test-account30/BeltClock/PCB/motherboard_MK2.pdf

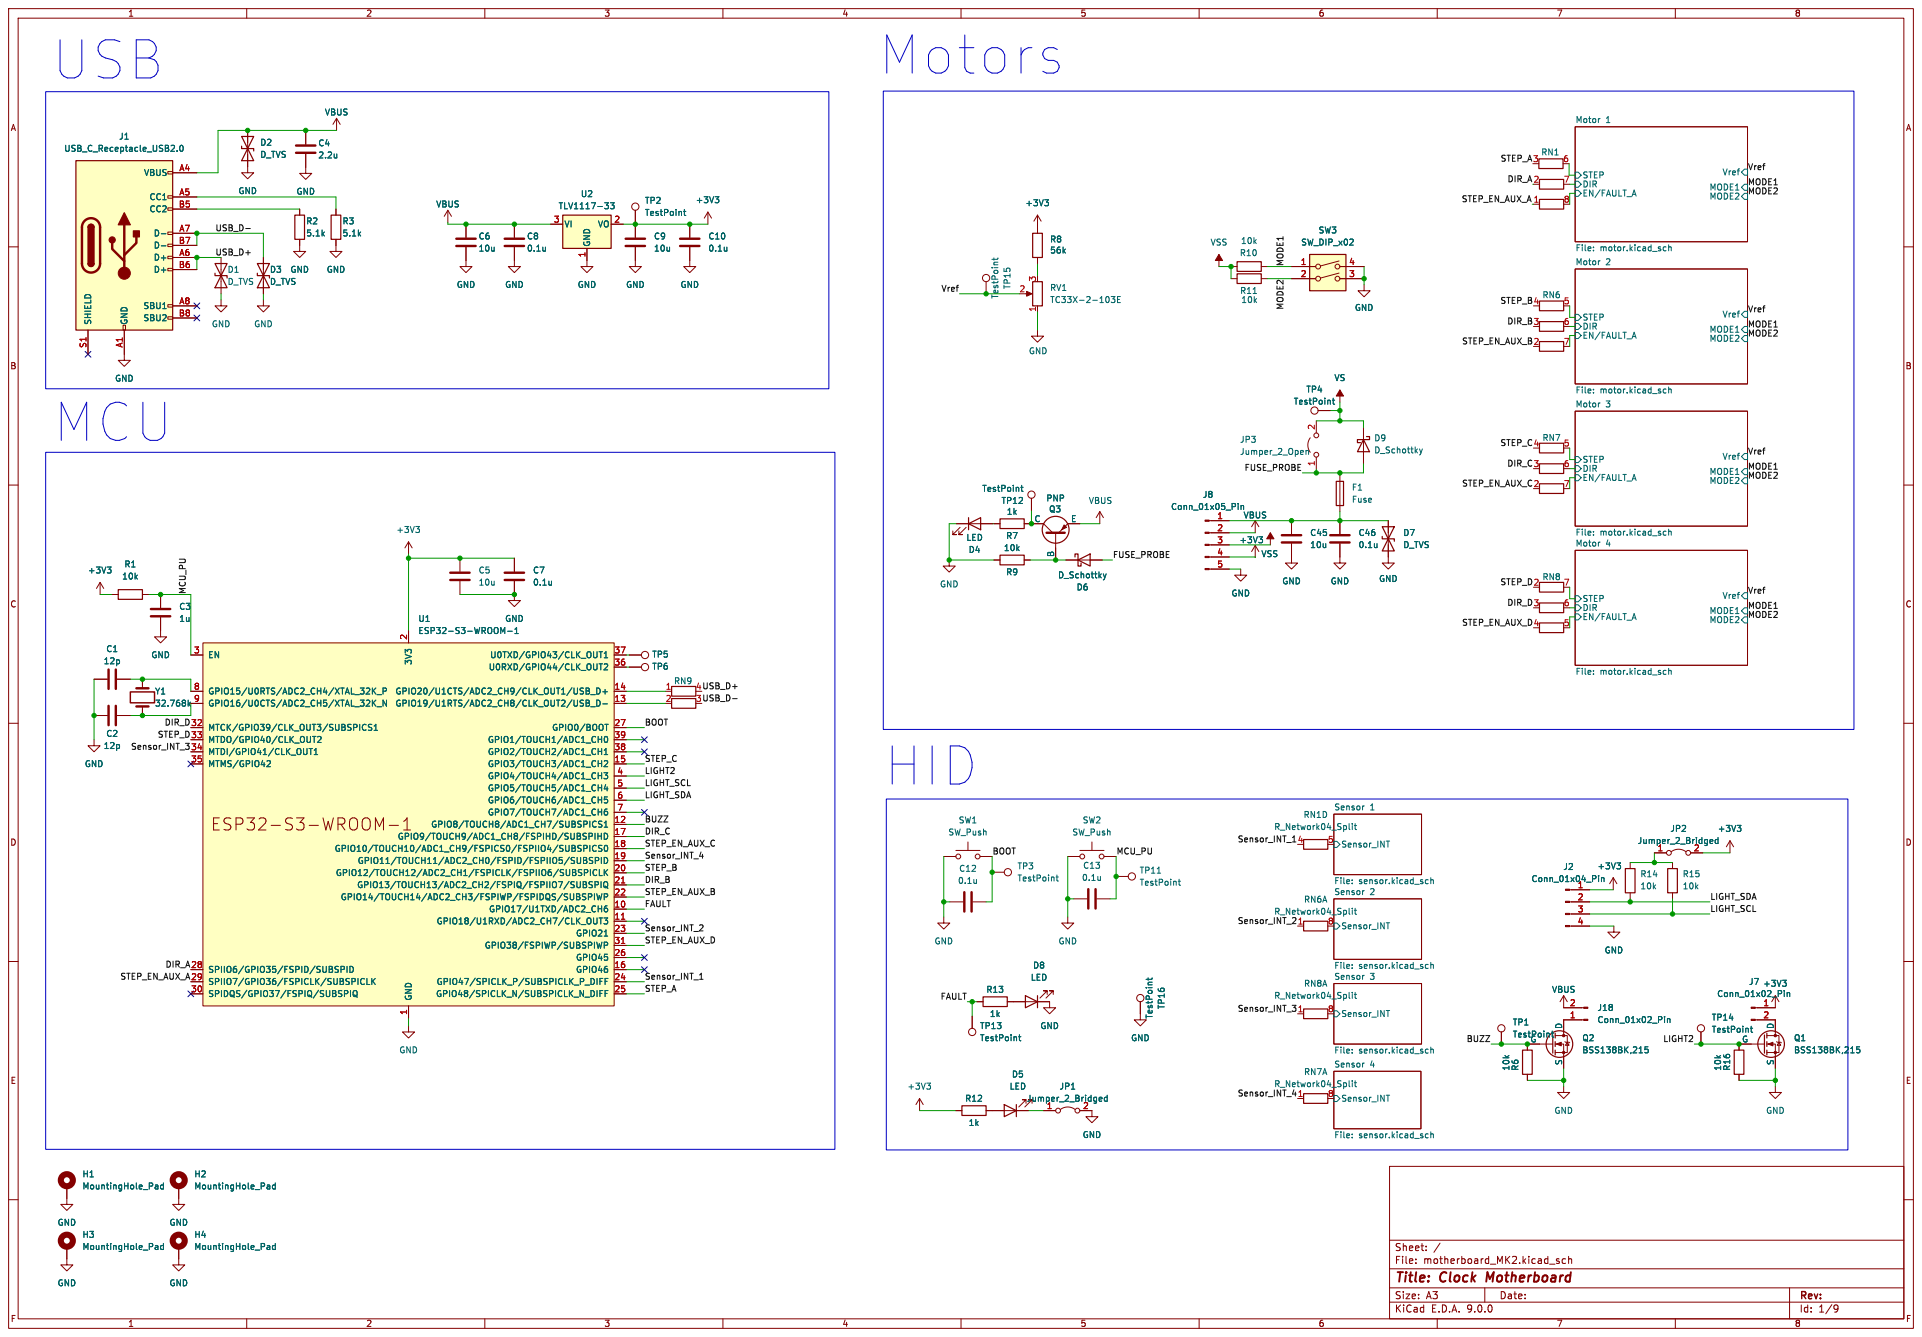
[picture p1: page 1]

1 U0TXD/GPIO43/CLK_OUT1 37 U0RXD/GPIO44/CLK_OUT2 36 GPIO20/U1CTS/ADC2_CH9/CLK_OUT1/USB_D+ 14 GPIO19/U1RTS/ADC2_CH8/CLK_OUT2/USB_D- 13 GPIO0/BOOT 27 GPIO1/TOUCH1/ADC1_CH0 39 GPIO2/TOUCH2/ADC1_CH1 38 GPIO3/TOUCH3/ADC1_CH2 15 GPIO4/TOUCH4/ADC1_CH3 4 GPIO5/TOUCH5/ADC1_CH4 5 GPIO6/TOUCH6/ADC1_CH5 6 GPIO7/TOUCH7/ADC1_CH6 7 GPIO8/TOUCH8/ADC1_CH7/SUBSPICS1 12 GPIO9/TOUCH9/ADC1_CH8/FSPIHD/SUBSPIHD 17 GPIO10/TOUCH10/ADC1_CH9/FSPICS0/FSPIIO4/SUBSPICS0 18 GPIO11/TOUCH11/ADC2_CH0/FSPID/FSPIIO5/SUBSPID 19 GPIO12/TOUCH12/ADC2_CH1/FSPICLK/FSPIIO6/SUBSPICLK 20 GPIO13/TOUCH13/ADC2_CH2/FSPIQ/FSPIIO7/SUBSPIQ 21 GPIO14/TOUCH14/ADC2_CH3/FSPIWP/FSPIDQS/SUBSPIWP 22 GPIO17/U1TXD/ADC2_CH6 10 GPIO18/U1RXD/ADC2_CH7/CLK_OUT3 11 GPIO21 23 GPIO38/FSPIWP/SUBSPIWP 31 GPIO45 26 GPIO46 16 GPIO47/SPICLK_P/SUBSPICLK_P_DIFF 24 GPIO48/SPICLK_N/SUBSPICLK_N_DIFF 25 U1ESP32-S3-WROOM-1 GND

1 U0TXD/GPIO43/CLK_OUT1 37 U0RXD/GPIO44/CLK_OUT2 36 GPIO20/U1CTS/ADC2_CH9/CLK_OUT1/USB_D+ 14 GPIO19/U1RTS/ADC2_CH8/CLK_OUT2/USB_D- 13 GPIO0/BOOT 27 GPIO1/TOUCH1/ADC1_CH0 39 GPIO2/TOUCH2/ADC1_CH1 38 GPIO3/TOUCH3/ADC1_CH2 15 GPIO4/TOUCH4/ADC1_CH3 4 GPIO5/TOUCH5/ADC1_CH4 5 GPIO6/TOUCH6/ADC1_CH5 6 GPIO7/TOUCH7/ADC1_CH6 7 GPIO8/TOUCH8/ADC1_CH7/SUBSPICS1 12 GPIO9/TOUCH9/ADC1_CH8/FSPIHD/SUBSPIHD 17 GPIO10/TOUCH10/ADC1_CH9/FSPICS0/FSPIIO4/SUBSPICS0 18 GPIO11/TOUCH11/ADC2_CH0/FSPID/FSPIIO5/SUBSPID 19 GPIO12/TOUCH12/ADC2_CH1/FSPICLK/FSPIIO6/SUBSPICLK 20 GPIO13/TOUCH13/ADC2_CH2/FSPIQ/FSPIIO7/SUBSPIQ 21 GPIO14/TOUCH14/ADC2_CH3/FSPIWP/FSPIDQS/SUBSPIWP 22 GPIO17/U1TXD/ADC2_CH6 10 GPIO18/U1RXD/ADC2_CH7/CLK_OUT3 11 GPIO21 23 GPIO38/FSPIWP/SUBSPIWP 31 GPIO45 26 GPIO46 16 GPIO47/SPICLK_P/SUBSPICLK_P_DIFF 24 GPIO48/SPICLK_N/SUBSPICLK_N_DIFF 25 H3 MountingHole_Pad H4 MountingHole_Pad GND

File: motherboard_MK2.kicad_sch Sheet: / Sensor_INT Sensor 4 File: sensor.kicad_sch Sensor_INT Sensor 3 File: sensor.kicad_sch

Id: 1/9 Title: Clock Motherboard

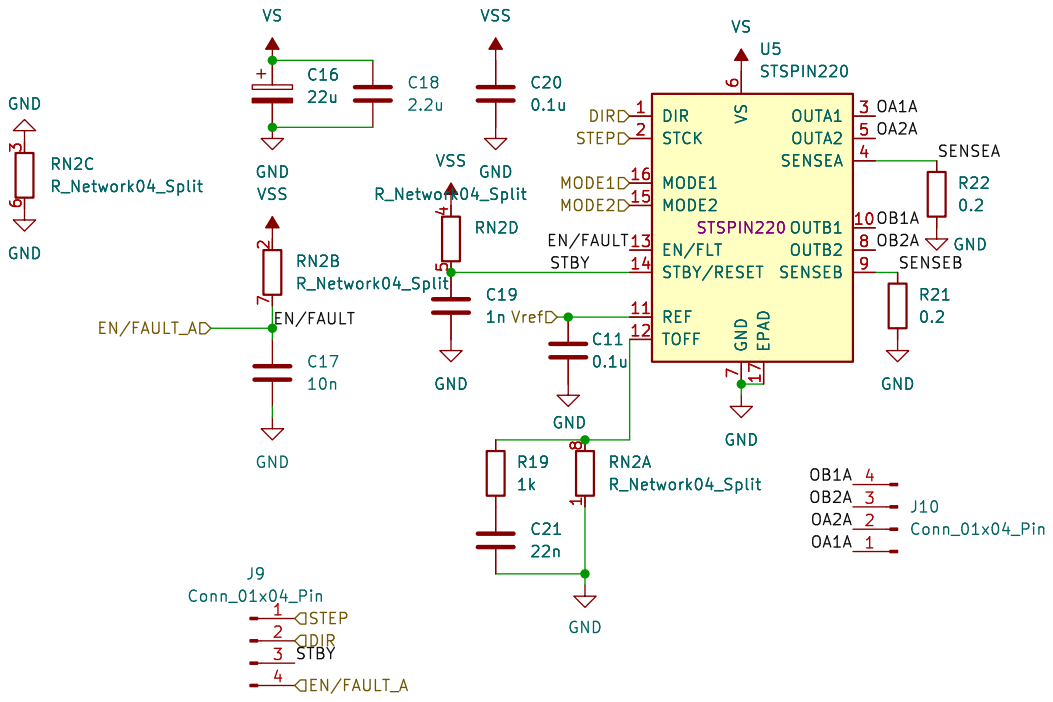
[picture p2: page 2]

7 EPAD 17 OUTA1 3 OUTA2 5 SENSEA 4 OUTB1 10 OUTB2 8 SENSEB 9 VS GND

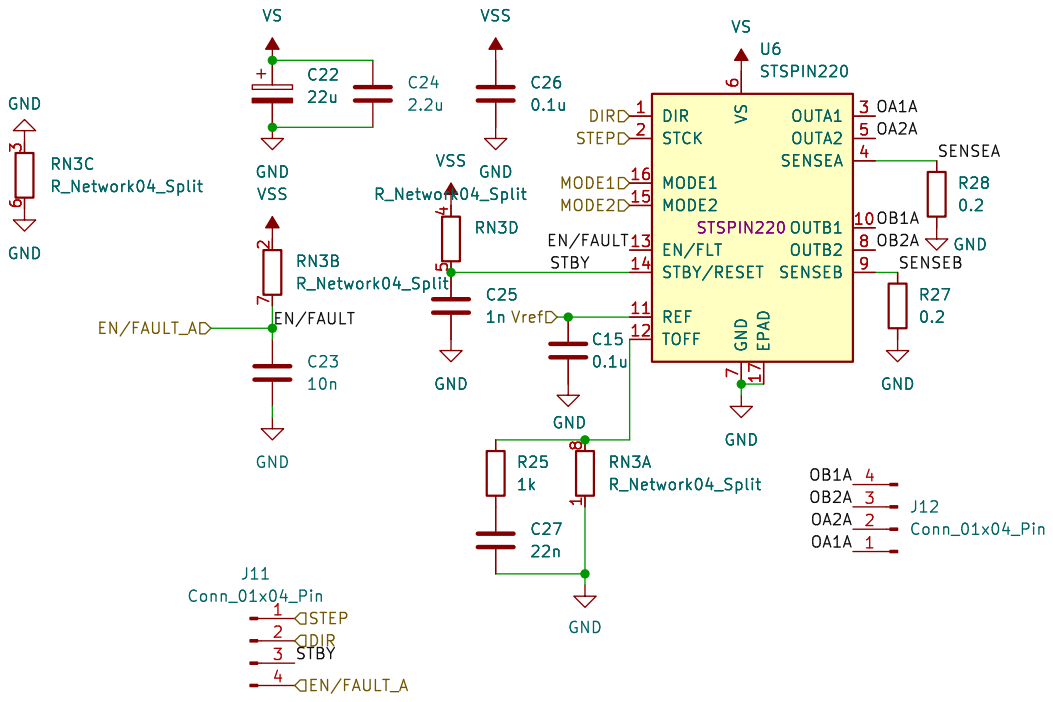
[picture p3: page 3]

7 EPAD 17 OUTA1 3 OUTA2 5 SENSEA 4 OUTB1 10 OUTB2 8 SENSEB 9 U6STSPIN220 STSPIN220 GND

7 EPAD 17 OUTA1 3 OUTA2 5 SENSEA 4 OUTB1 10 OUTB2 8 SENSEB 9 GND

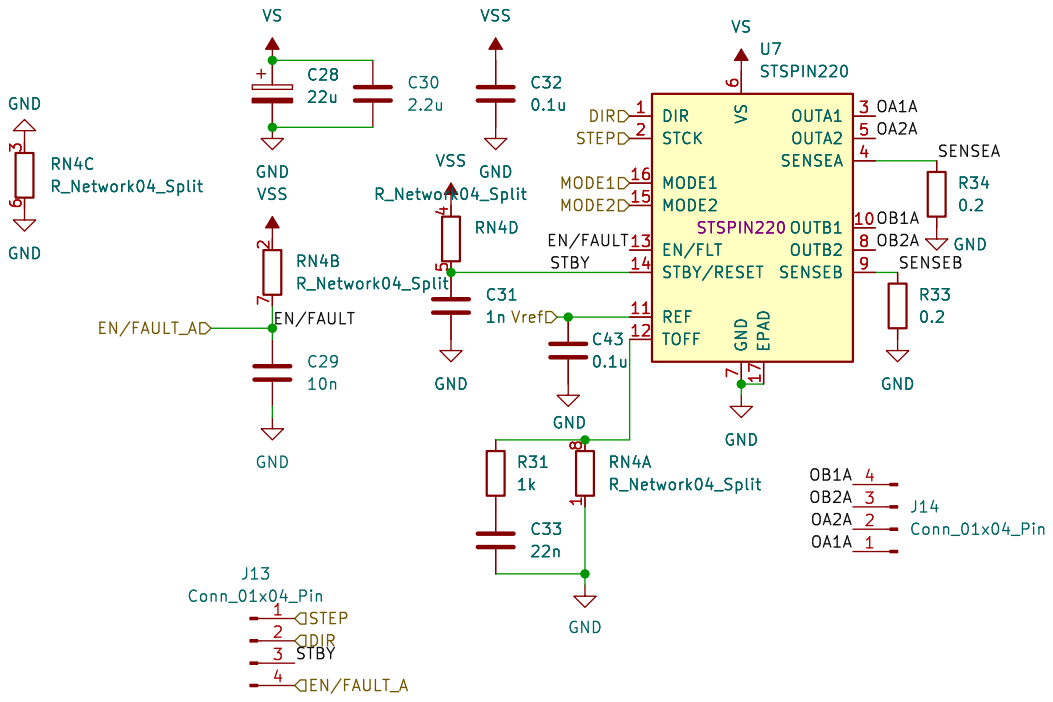
[picture p4: page 4]
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

7 EPAD 17 OUTA1 3 OUTA2 5 SENSEA 4 OUTB1 10 OUTB2 8 SENSEB 9 U7STSPIN220 STSPIN220 GND

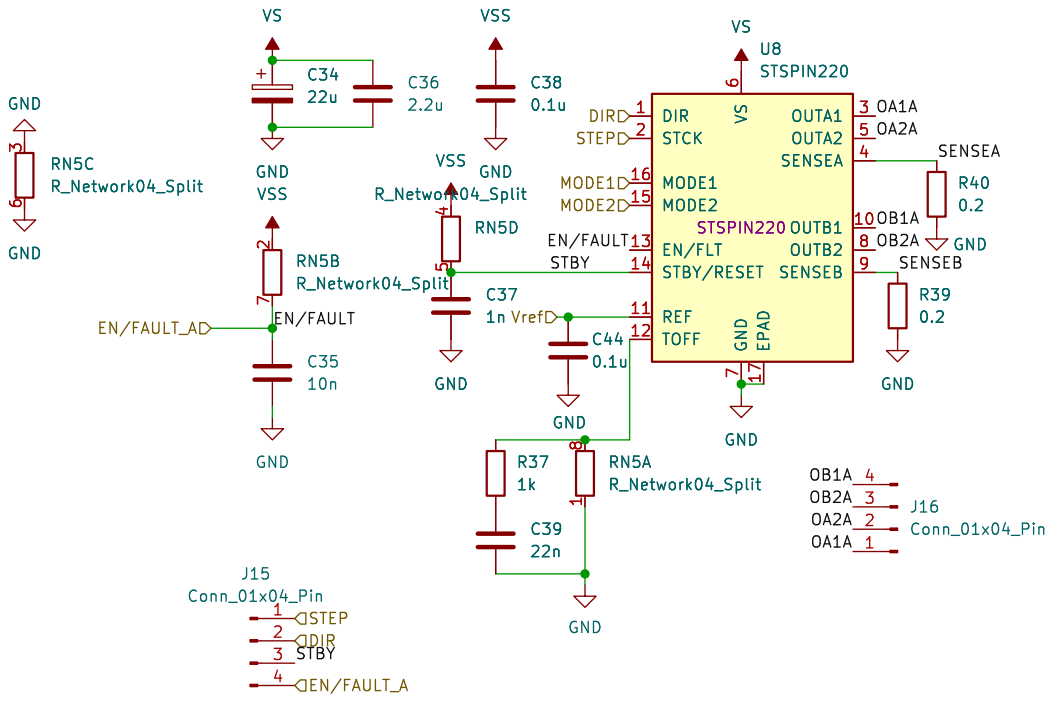
[picture p5: page 5]

7 EPAD 17 OUTA1 3 OUTA2 5 SENSEA 4 OUTB1 10 OUTB2 8 SENSEB 9 U8STSPIN220 STSPIN220 GND

7 EPAD 17 OUTA1 3 OUTA2 5 SENSEA 4 OUTB1 10 OUTB2 8 SENSEB 9 GND

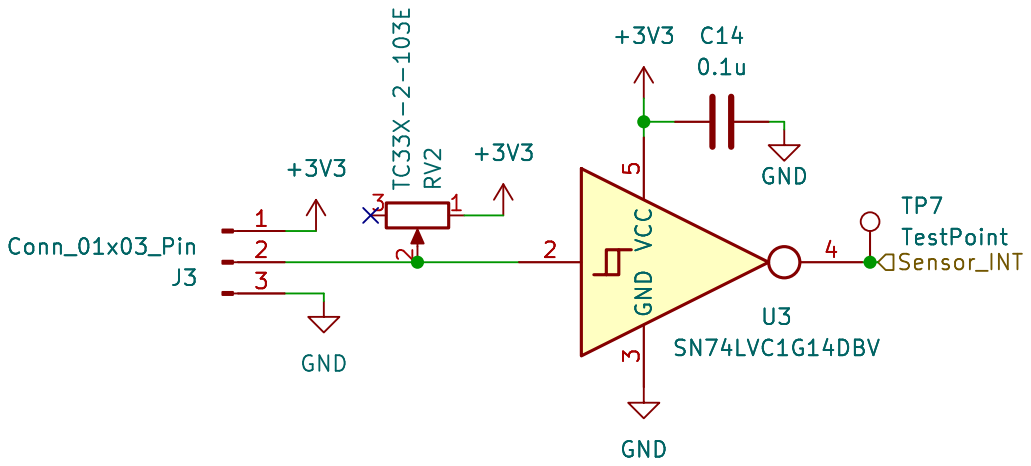
[picture p6: page 6]

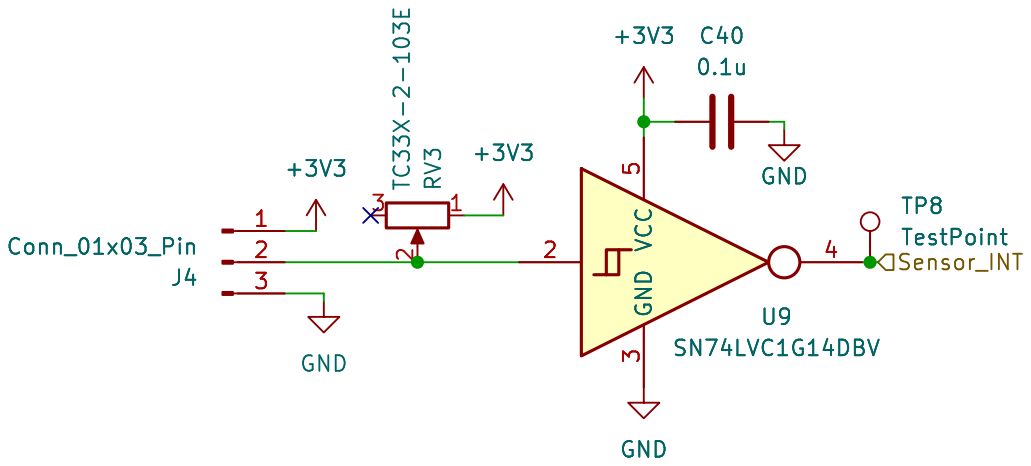
[picture p7: page 7]

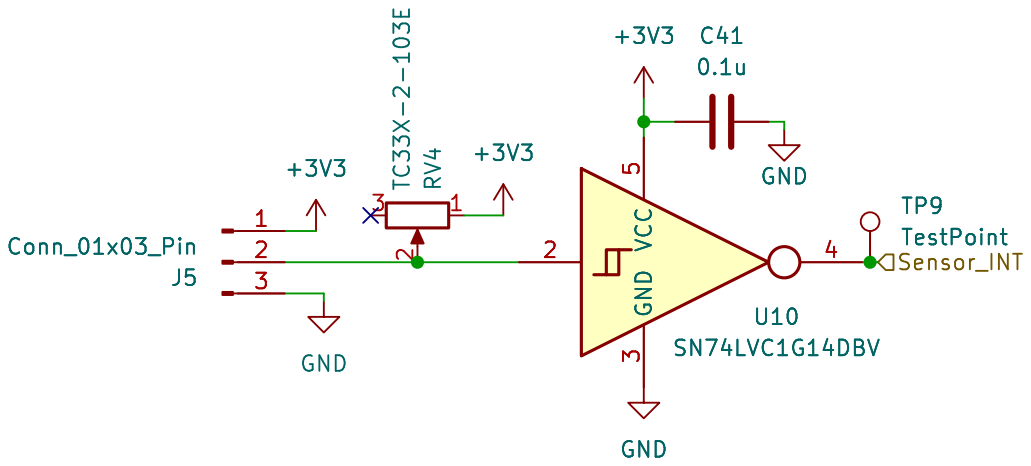
[picture p8: page 8]

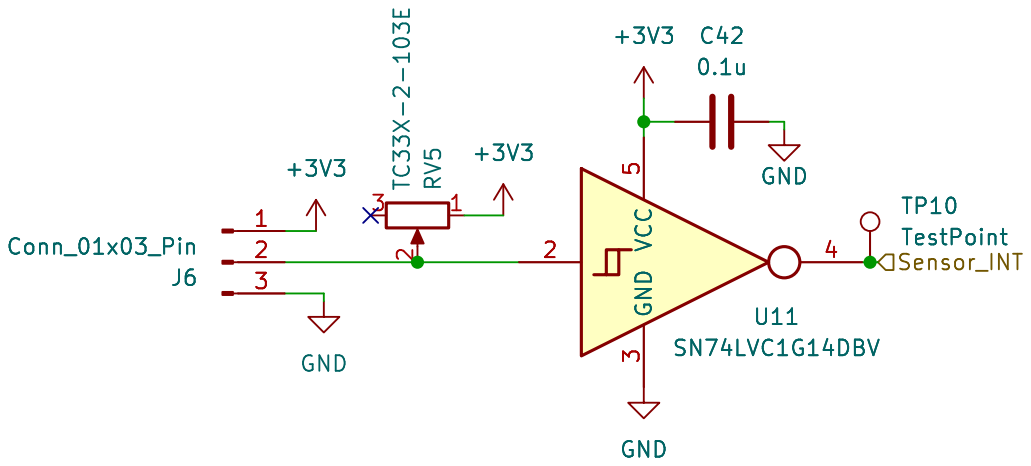
[picture p9: page 9]
