test-account30/BeltClock/PCB/motherboard_MK2.kicad_pcb

## KiCad design PCB/motherboard_MK2.kicad_pcb (2025-03-05)

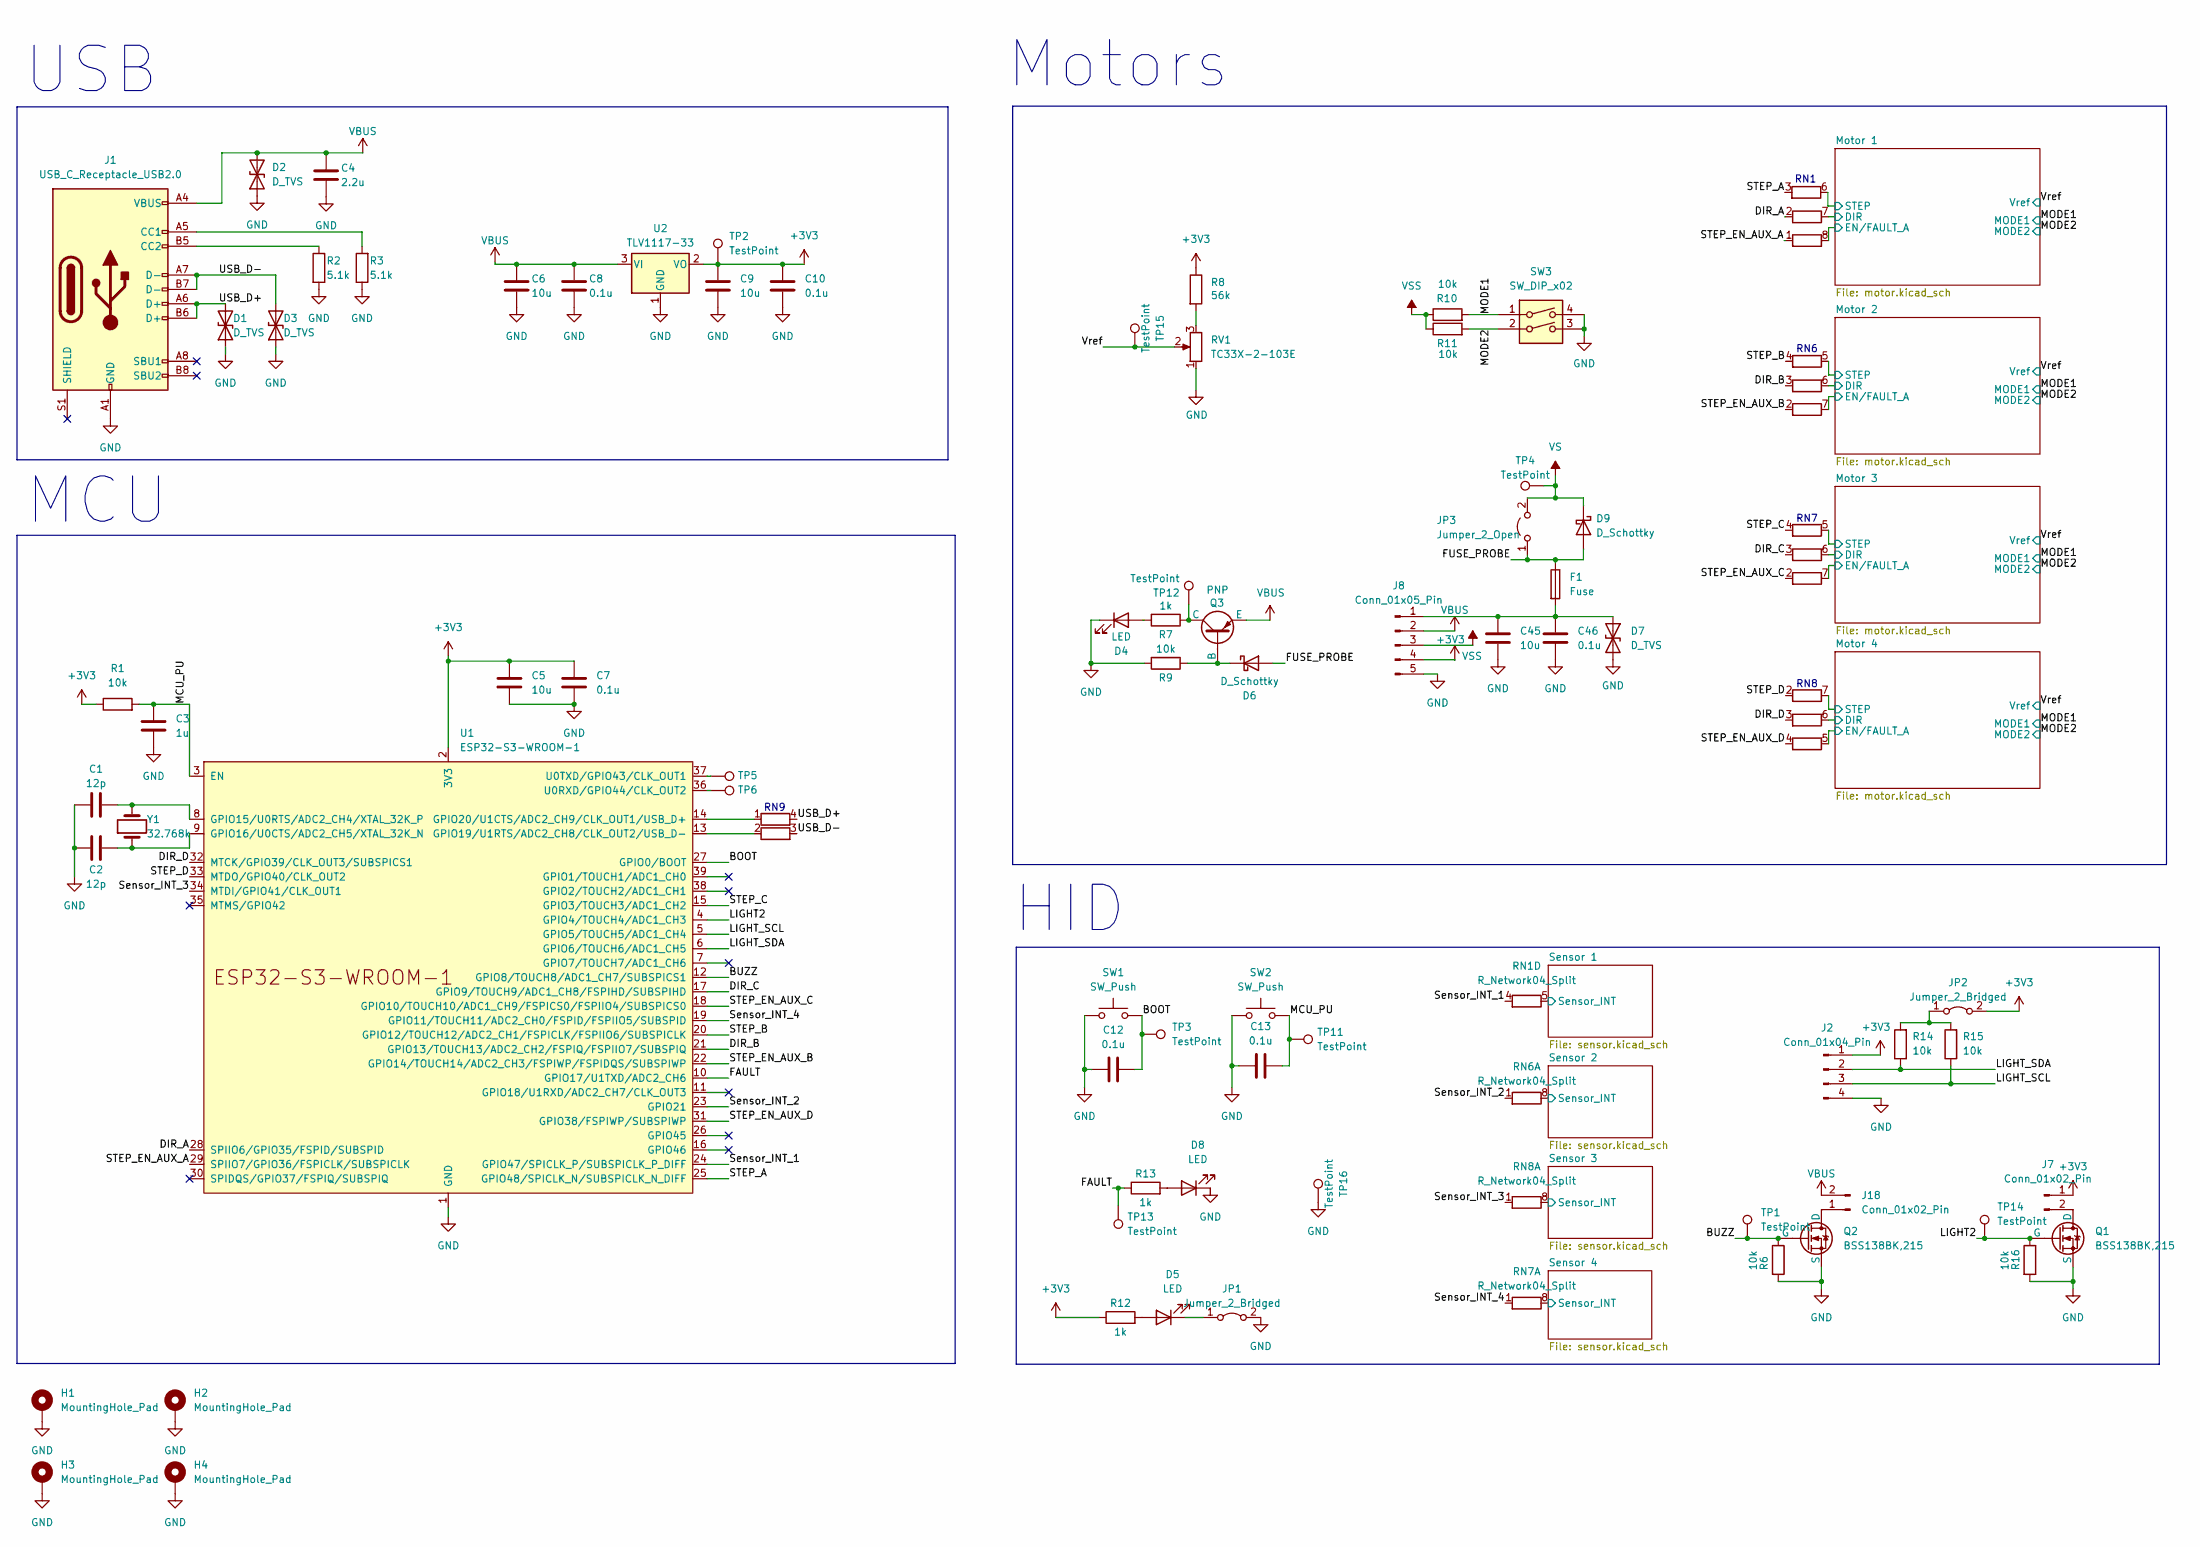
[picture p10: schematic motherboard_MK2.kicad_sch, Clock Motherboard]

Parts:
C1, C2: 12p; C_0603_1608Metric; Part Number VJ0805A120FXJCW1BC
C3: 1u; C_0603_1608Metric; Part Number CL10A105KO8NNNC
C4: 2.2u; C_0603_1608Metric; Part Number CL10A225KO8NNNC
C5, C6, C9, C45: 10u; C_1206_3216Metric; Part Number C1206C106K4PACTU
C7, C8, C10, C12, C13, C46: 0.1u; C_0603_1608Metric; Part Number CL10B104KO8NNNC
D1, D3: D_TVS; D_SOD-882; Part Number SP3021-01ETG
D2, D7: D_TVS; ZDO_SOD723_LTF-L; Part Number SP1003-01DTG
D4, D5, D8: LED; LED_0805_2012Metric; Part Number MCL-S270YC
D6: D_Schottky; D_SOD-523; Part Number RB540SM-40FHT2R
D9: D_Schottky; Nexperia_CFP3_SOD-123W; Part Number PMEG4030EXEX
F1: Fuse; Fuse_1206_3216Metric; Part Number F1206FA3000V032TM
H1, H2, H3, H4: MountingHole_Pad; MountingHole_3.2mm_M3; Part Number N/A
J1: USB_C_Receptacle_USB2.0; USB4120-03-C_GCT; Part Number USB4120-03-C
J2: Conn_01x04_Pin; Molex_PicoBlade_53048-0410_1x04_P1.25mm_Horizontal; Part Number 53048-0410
J7: Conn_01x02_Pin; Molex_PicoBlade_53048-0210_1x02_P1.25mm_Horizontal; Part Number 53047-0210
J8: Conn_01x05_Pin; PinHeader_1x05_P2.54mm_Vertical; Part Number generic
J18: Conn_01x02_Pin; Molex_PicoBlade_53047-0210_1x02_P1.25mm_Vertical; Part Number 53047-0210
JP1, JP2: Jumper_2_Bridged; SolderJumper-2_P1.3mm_Bridged2Bar_Pad1.0x1.5mm; Part Number N/A
JP3: Jumper_2_Open; SolderJumper-2_P1.3mm_Open_Pad1.0x1.5mm; Part Number N/A
Q1, Q2: BSS138BK,215; SOT-23; Part Number BSS138BK,215
Q3: PNP; SOT-23; Part Number DSS5240T-7
R1, R6, R10, R11, R14, R15, R16: 10k; R_0603_1608Metric; Part Number MR06X1002FTLV
R2, R3: 5.1k; R_0603_1608Metric; Tolerance 1%; Part Number MCWR06X5101FTL
R7, R12, R13: 1k; R_0805_2012Metric; Tolerence 10%; Part Number MCWR08X1001FTL
R8: 56k; R_0603_1608Metric; Part Number MR06X563 JTLV
R9: 10k; R_0603_1608Metric; Tolerence 10%; Part Number MR06X1002FTLV
RN1, RN6, RN7, RN8: R_Network04_Split; R_Array_Convex_4x0402; Part Number MCPNF42JT-YR0R0
RN9: R_Pack02_Split; R_Array_Convex_2x0402; Part Number MCPNF22JT-YR0R0
RV1: TC33X-2-103E; Potentiometer_Bourns_TC33X_Vertical; Part Number TC33X-2-103E
SW1, SW2: SW_Push; SW_SPST_TL3305A; Part Number TL3305AF160QG.
SW3: SW_DIP_x02; DIP-4_W7.62mm; Part Number MCNDI-02S
TP1, TP3, TP11, TP12, TP13, TP14: TestPoint; TestPoint_Pad_D1.0mm; Part Number N/A
TP2, TP4, TP5, TP6, TP16: TestPoint; TestPoint_Pad_1.0x1.0mm; Part Number N/A
TP15: TestPoint; TestPoint_Pad_2.0x2.0mm; Part Number N/A
U1: ESP32-S3-WROOM-1; Part Number DFR0896
U2: TLV1117-33; SOT-223; Part Number LD1117S33CTR
Y1: 32.768k; Crystal_SMD_3215-2Pin_3.2x1.5mm; Part Number RT3215-32.768-12.5-TR-10PPM

Connections:
+3V3: C5.1, C7.1, C9.1, C10.1, J2.1, J7.1, J8.4, JP2.2 (B), R1.1, R8.1, R12.1, TP2.1, U1.2 (3V3), U2.2 (VO); also elsewhere on the board
/BOOT: C12.1, SW1.2, TP3.1, U1.27 (GPIO0/BOOT)
/BUZZ: Q2.2 (G), R6.1, TP1.1, U1.12 (GPIO8/TOUCH8/ADC1_CH7/SUBSPICS1)
/DIR_A: RN1.2, U1.28 (SPIIO6/GPIO35/FSPID/SUBSPID)
/DIR_B: RN6.3, U1.21 (GPIO13/TOUCH13/ADC2_CH2/FSPIQ/FSPIIO7/S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)
/DIR_C: RN7.3, U1.17 (GPIO9/TOUCH9/ADC1_CH8/FSPIHD/SUBSPIHD)
/DIR_D: RN8.3, U1.32 (MTCK/GPIO39/CLK_OUT3/SUBSPICS1)
/FAULT: R13.1, TP13.1, U1.10 (GPIO17/U1TXD/ADC2_CH6)
/FUSE_PROBE: D6.2 (A), D9.2 (A), F1.1, JP3.1 (A)
/LIGHT2: Q1.2 (G), R16.1, TP14.1, U1.4 (GPIO4/TOUCH4/ADC1_CH3)
/LIGHT_SCL: J2.3, R15.1, U1.5 (GPIO5/TOUCH5/ADC1_CH4)
/LIGHT_SDA: J2.2, R14.1, U1.6 (GPIO6/TOUCH6/ADC1_CH5)
/MCU_PU: C3.1, C13.1, R1.2, SW2.2, TP11.1, U1.3 (EN)
/MODE1: R10.2, SW3.1; also elsewhere on the board
/MODE2: R11.2, SW3.2; also elsewhere on the board
/Motor 1/DIR: RN1.7; also elsewhere on the board
/Motor 1/EN/FAULT: RN1.8; also elsewhere on the board
/Motor 1/STEP: RN1.6; also elsewhere on the board
/Motor 2/DIR: RN6.6; also elsewhere on the board
/Motor 2/EN/FAULT: RN6.7; also elsewhere on the board
/Motor 2/STEP: RN6.5; also elsewhere on the board
/Motor 3/DIR: RN7.6; also elsewhere on the board
/Motor 3/EN/FAULT: RN7.7; also elsewhere on the board
/Motor 3/STEP: RN7.5; also elsewhere on the board
/Motor 4/DIR: RN8.6; also elsewhere on the board
/Motor 4/EN/FAULT: RN8.5; also elsewhere on the board
/Motor 4/STEP: RN8.7; also elsewhere on the board
/STEP_A: RN1.3, U1.25 (GPIO48/SPICLK_N/SUBSPICLK_N_DIFF)
/STEP_B: RN6.4, U1.20 (GPIO12/TOUCH12/ADC2_CH1/FSPICLK/FSPIIO6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)
/STEP_C: RN7.4, U1.15 (GPIO3/TOUCH3/ADC1_CH2)
/STEP_D: RN8.2, U1.33 (MTDO/GPIO40/CLK_OUT2)
/STEP_EN_AUX_A: RN1.1, U1.29 (SPIIO7/GPIO36/FSPICLK/SUBSPICLK)
/STEP_EN_AUX_B: RN6.2, U1.22 (GPIO14/TOUCH14/ADC2_CH3/FSPIWP/FSPIDQS/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)
/STEP_EN_AUX_C: RN7.2, U1.18 (GPIO10/TOUCH10/ADC1_CH9/FSPICS0/FSPIIO4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)
/STEP_EN_AUX_D: RN8.4, U1.31 (GPIO38/FSPIWP/SUBSPIWP)
/Sensor 1/Sensor_INT: RN1.5; also elsewhere on the board
/Sensor 2/Sensor_INT: RN6.8; also elsewhere on the board
/Sensor 3/Sensor_INT: RN8.8; also elsewhere on the board
/Sensor 4/Sensor_INT: RN7.8; also elsewhere on the board
/Sensor_INT_1: RN1.4, U1.24 (GPIO47/SPICLK_P/SUBSPICLK_P_DIFF)
/Sensor_INT_2: RN6.1, U1.23 (GPIO21)
/Sensor_INT_3: RN8.1, U1.34 (MTDI/GPIO41/CLK_OUT1)
/Sensor_INT_4: RN7.1, U1.19 (GPIO11/TOUCH11/ADC2_CH0/FSPID/FSPIIO5/S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)
/USB_D+: D1.2 (A2), J1.A6 (D+), J1.B6 (D+), RN9.4 (R1.2)
/USB_D-: D3.2 (A2), J1.A7 (D-), J1.B7 (D-), RN9.3 (R2.2)
/Vref: RV1.2, TP15.1; also elsewhere on the board
GND: C1.1, C2.1, C3.2, C4.2, C5.2, C6.2, C7.2, C8.2, C9.2, C10.2, C12.2, C13.2, C45.2, C46.2, D1.1 (A1), D2.1 (A1), D3.1 (A1), D4.1 (K), D7.2 (A2), D8.1 (K), H1.1, H2.1, H3.1, H4.1, J1.A1 (GND), J1.A12 (GND), J1.B1 (GND), J1.B12 (GND), J2.4, J8.5, JP1.2 (B), Q1.3 (S), Q2.3 (S), R2.2, R3.1, R6.2, R9.2, R16.2, RV1.1, SW1.1, SW2.1, SW3.3, SW3.4, TP16.1, U1.1 (GND), U1.40 (GND), U1.41 (GND), U2.1 (GND); also elsewhere on the board
unnamed: D4.2 (A), R7.2
unnamed: D5.2 (A), R12.2
unnamed: D5.1 (K), JP1.1 (A)
unnamed: D6.1 (K), Q3.2 (B), R9.1
unnamed: C45.1, C46.1, D7.1 (A1), F1.2, J8.1
unnamed: D8.2 (A), R13.2
unnamed: J1.A5 (CC1), R3.2
unnamed: J1.B5 (CC2), R2.1
unnamed: J7.2, Q1.1 (D)
unnamed: J18.1, Q2.1 (D)
unnamed: JP2.1 (A), R14.2, R15.2
unnamed: Q3.1 (C), R7.1, TP12.1
unnamed: R8.2, RV1.3
unnamed: RN9.1 (R1.1), U1.14 (GPIO20/U1CTS/ADC2_CH9/CLK_OUT1/USB_D+)
unnamed: RN9.2 (R2.1), U1.13 (GPIO19/U1RTS/ADC2_CH8/CLK_OUT2/USB_D-)
unnamed: C1.2, U1.8 (GPIO15/U0RTS/ADC2_CH4/XTAL_32K_P), Y1.2
unnamed: C2.2, U1.9 (GPIO16/U0CTS/ADC2_CH5/XTAL_32K_N), Y1.1
unnamed: TP6.1, U1.36 (U0RXD/GPIO44/CLK_OUT2)
unnamed: TP5.1, U1.37 (U0TXD/GPIO43/CLK_OUT1)
VBUS: C4.1, C6.1, C8.1, D2.2 (A2), J1.A4 (VBUS), J1.A9 (VBUS), J1.B4 (VBUS), J1.B9 (VBUS), J8.2, J18.2, Q3.3 (E), U2.3 (VI)
VS: D9.1 (K), JP3.2 (B), TP4.1; also elsewhere on the board
VSS: J8.3, R10.1, R11.1; also elsewhere on the board

Notes on the sheet:
RN6
HID
USB
Motors
RN9
RN8
RN1
RN7
MCU

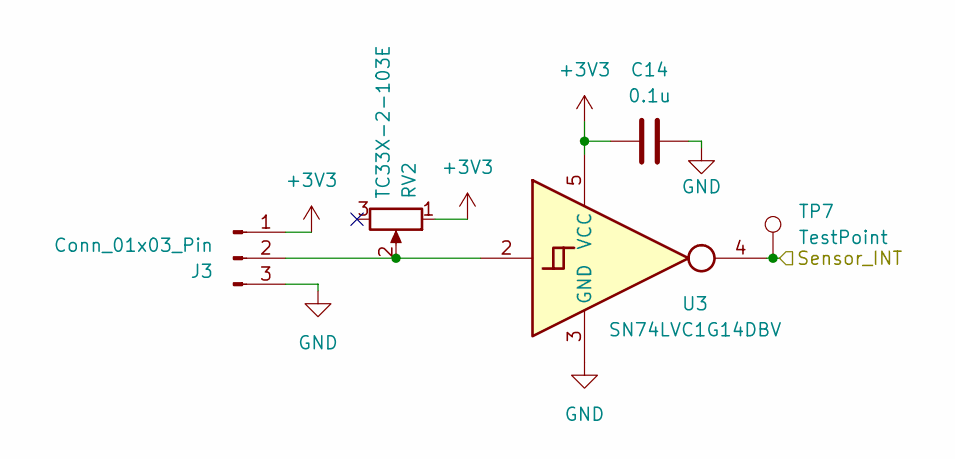
[picture p11: schematic sensor.kicad_sch]

Parts:
C14: 0.1u; C_0603_1608Metric; Part Number CL10B104KO8NNNC
J3: Conn_01x03_Pin; Molex_PicoBlade_53048-0310_1x03_P1.25mm_Horizontal; Part Number 53048-0310
RV2: TC33X-2-103E; Potentiometer_Bourns_TC33X_Vertical; Part Number TC33X-2-103E
TP7: TestPoint; TestPoint_Pad_D1.0mm; Part Number N/A
U3: SN74LVC1G14DBV; SC-74A-5_1.55x2.9mm_P0.95mm; Part Number 74LVC1G14GW-Q100,1

Connections:
+3V3: C14.1, J3.1, RV2.1, U3.5 (VCC); also elsewhere on the board
/Sensor 1/Sensor_INT: TP7.1, U3.4; also elsewhere on the board
GND: C14.2, J3.3, U3.3 (GND); also elsewhere on the board
unnamed: J3.2, RV2.2, U3.2

Parts of its further copies:
C40, C41, C42: 0.1u; C_0603_1608Metric; Part Number CL10B104KO8NNNC
J4, J5, J6: Conn_01x03_Pin; Molex_PicoBlade_53048-0310_1x03_P1.25mm_Horizontal; Part Number 53048-0310
RV3, RV4, RV5: TC33X-2-103E; Potentiometer_Bourns_TC33X_Vertical; Part Number TC33X-2-103E
TP8, TP9, TP10: TestPoint; TestPoint_Pad_D1.0mm; Part Number N/A
U9, U10, U11: SN74LVC1G14DBV; SC-74A-5_1.55x2.9mm_P0.95mm; Part Number 74LVC1G14GW-Q100,1

Connections of its further copies:
+3V3: C40.1, C41.1, C42.1, J4.1, J5.1, J6.1, RV3.1, RV4.1, RV5.1, U9.5 (VCC), U10.5 (VCC), U11.5 (VCC); also elsewhere on the board
/Sensor 2/Sensor_INT: TP8.1, U9.4; also elsewhere on the board
/Sensor 3/Sensor_INT: TP9.1, U10.4; also elsewhere on the board
/Sensor 4/Sensor_INT: TP10.1, U11.4; also elsewhere on the board
GND: C40.2, C41.2, C42.2, J4.3, J5.3, J6.3, U9.3 (GND), U10.3 (GND), U11.3 (GND); also elsewhere on the board
unnamed: J4.2, RV3.2, U9.2
unnamed: J5.2, RV4.2, U10.2
unnamed: J6.2, RV5.2, U11.2

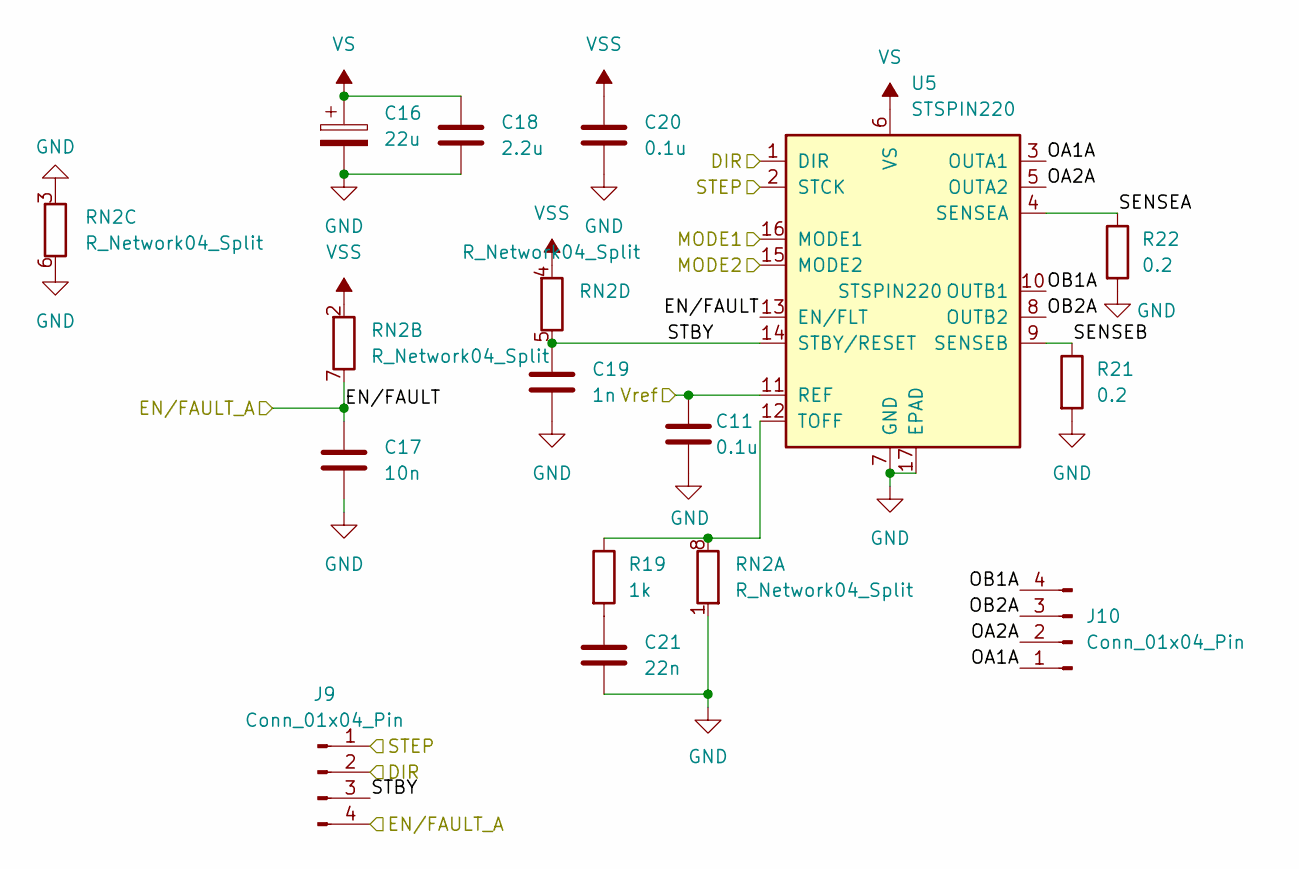
[picture p12: schematic motor.kicad_sch]

Parts:
C11, C20: 0.1u; C_0603_1608Metric; Part Number CL10B104KO8NNNC
C16: 22u; CP_Elec_5x5.4; Part Number MCVVT016M220DA1L
C17: 10n; C_0603_1608Metric; Part Number MC0603B103K160CT
C18: 2.2u; C_0603_1608Metric; Part Number CL10A225KO8NNNC
C19: 1n; C_0603_1608Metric; Part Number CC0603KRX7R7BB102
C21: 22n; C_0603_1608Metric; Part Number KGM15AR71C222KT
J9: Conn_01x04_Pin; PinHeader_1x04_P2.54mm_Vertical; Part Number generic
J10: Conn_01x04_Pin; Molex_PicoBlade_53048-0410_1x04_P1.25mm_Horizontal; Part Number 53048-0410
R19: 1k; R_0603_1608Metric; Part Number MR06X1001FTLV
R21, R22: 0.2; R_0805_2012Metric; Part Number WW08WR200FTL
RN2: R_Network04_Split; R_Array_Convex_4x0603; Part Number WA06X103 JTL
U5: STSPIN220; VQFN-16-1EP_3x3mm_P0.5mm_EP1.8x1.8mm_ThermalVias; Part Number STSPIN220

Connections:
/MODE1: U5.16 (MODE1); also elsewhere on the board
/MODE2: U5.15 (MODE2); also elsewhere on the board
/Motor 1/DIR: J9.2, U5.1 (DIR); also elsewhere on the board
/Motor 1/EN/FAULT: C17.1, J9.4, RN2.7, U5.13 (EN/FLT); also elsewhere on the board
/Motor 1/OA1A: J10.1, U5.3 (OUTA1)
/Motor 1/OA2A: J10.2, U5.5 (OUTA2)
/Motor 1/OB1A: J10.4, U5.10 (OUTB1)
/Motor 1/OB2A: J10.3, U5.8 (OUTB2)
/Motor 1/SENSEA: R22.1, U5.4 (SENSEA)
/Motor 1/SENSEB: R21.1, U5.9 (SENSEB)
/Motor 1/STBY: C19.1, J9.3, RN2.5, U5.14 (STBY/RESET)
/Motor 1/STEP: J9.1, U5.2 (STCK); also elsewhere on the board
/Vref: C11.1, U5.11 (REF); also elsewhere on the board
GND: C11.2, C16.2, C17.2, C18.2, C19.2, C20.2, C21.2, R21.2, R22.2, RN2.1, RN2.3, RN2.6, U5.7 (GND), U5.17 (EPAD); also elsewhere on the board
unnamed: C21.1, R19.2
unnamed: R19.1, RN2.8, U5.12 (TOFF)
VS: C16.1, C18.1, U5.6 (VS); also elsewhere on the board
VSS: C20.1, RN2.2, RN2.4; also elsewhere on the board

Parts of its further copies:
C15, C26, C32, C38, C43, C44: 0.1u; C_0603_1608Metric; Part Number CL10B104KO8NNNC
C22, C28, C34: 22u; CP_Elec_5x5.4; Part Number MCVVT016M220DA1L
C23, C29, C35: 10n; C_0603_1608Metric; Part Number MC0603B103K160CT
C24, C30, C36: 2.2u; C_0603_1608Metric; Part Number CL10A225KO8NNNC
C25, C31, C37: 1n; C_0603_1608Metric; Part Number CC0603KRX7R7BB102
C27, C33, C39: 22n; C_0603_1608Metric; Part Number KGM15AR71C222KT
J11, J13, J15: Conn_01x04_Pin; PinHeader_1x04_P2.54mm_Vertical; Part Number generic
J12, J14, J16: Conn_01x04_Pin; Molex_PicoBlade_53048-0410_1x04_P1.25mm_Horizontal; Part Number 53048-0410
R25, R31, R37: 1k; R_0603_1608Metric; Part Number MR06X1001FTLV
R27, R28, R33, R34, R39, R40: 0.2; R_0805_2012Metric; Part Number WW08WR200FTL
RN3, RN4, RN5: R_Network04_Split; R_Array_Convex_4x0603; Part Number WA06X103 JTL
U6, U7, U8: STSPIN220; VQFN-16-1EP_3x3mm_P0.5mm_EP1.8x1.8mm_ThermalVias; Part Number STSPIN220

Connections of its further copies:
/MODE1: U6.16 (MODE1), U7.16 (MODE1), U8.16 (MODE1); also elsewhere on the board
/MODE2: U6.15 (MODE2), U7.15 (MODE2), U8.15 (MODE2); also elsewhere on the board
/Motor 2/DIR: J11.2, U6.1 (DIR); also elsewhere on the board
/Motor 2/EN/FAULT: C23.1, J11.4, RN3.7, U6.13 (EN/FLT); also elsewhere on the board
/Motor 2/OA1A: J12.1, U6.3 (OUTA1)
/Motor 2/OA2A: J12.2, U6.5 (OUTA2)
/Motor 2/OB1A: J12.4, U6.10 (OUTB1)
/Motor 2/OB2A: J12.3, U6.8 (OUTB2)
/Motor 2/SENSEA: R28.1, U6.4 (SENSEA)
/Motor 2/SENSEB: R27.1, U6.9 (SENSEB)
/Motor 2/STBY: C25.1, J11.3, RN3.5, U6.14 (STBY/RESET)
/Motor 2/STEP: J11.1, U6.2 (STCK); also elsewhere on the board
/Motor 3/DIR: J13.2, U7.1 (DIR); also elsewhere on the board
/Motor 3/EN/FAULT: C29.1, J13.4, RN4.7, U7.13 (EN/FLT); also elsewhere on the board
/Motor 3/OA1A: J14.1, U7.3 (OUTA1)
/Motor 3/OA2A: J14.2, U7.5 (OUTA2)
/Motor 3/OB1A: J14.4, U7.10 (OUTB1)
/Motor 3/OB2A: J14.3, U7.8 (OUTB2)
/Motor 3/SENSEA: R34.1, U7.4 (SENSEA)
/Motor 3/SENSEB: R33.1, U7.9 (SENSEB)
/Motor 3/STBY: C31.1, J13.3, RN4.5, U7.14 (STBY/RESET)
/Motor 3/STEP: J13.1, U7.2 (STCK); also elsewhere on the board
/Motor 4/DIR: J15.2, U8.1 (DIR); also elsewhere on the board
/Motor 4/EN/FAULT: C35.1, J15.4, RN5.7, U8.13 (EN/FLT); also elsewhere on the board
/Motor 4/OA1A: J16.1, U8.3 (OUTA1)
/Motor 4/OA2A: J16.2, U8.5 (OUTA2)
/Motor 4/OB1A: J16.4, U8.10 (OUTB1)
/Motor 4/OB2A: J16.3, U8.8 (OUTB2)
/Motor 4/SENSEA: R40.1, U8.4 (SENSEA)
/Motor 4/SENSEB: R39.1, U8.9 (SENSEB)
/Motor 4/STBY: C37.1, J15.3, RN5.5, U8.14 (STBY/RESET)
/Motor 4/STEP: J15.1, U8.2 (STCK); also elsewhere on the board
/Vref: C15.1, C43.1, C44.1, U6.11 (REF), U7.11 (REF), U8.11 (REF); also elsewhere on the board
GND: C15.2, C22.2, C23.2, C24.2, C25.2, C26.2, C27.2, C28.2, C29.2, C30.2, C31.2, C32.2, C33.2, C34.2, C35.2, C36.2, C37.2, C38.2, C39.2, C43.2, C44.2, R27.2, R28.2, R33.2, R34.2, R39.2, R40.2, RN3.1, RN3.3, RN3.6, RN4.1, RN4.3, RN4.6, RN5.1, RN5.3, RN5.6, U6.7 (GND), U6.17 (EPAD), U7.7 (GND), U7.17 (EPAD), U8.7 (GND), U8.17 (EPAD); also elsewhere on the board
unnamed: C27.1, R25.2
unnamed: C33.1, R31.2
unnamed: C39.1, R37.2
unnamed: R25.1, RN3.8, U6.12 (TOFF)
unnamed: R31.1, RN4.8, U7.12 (TOFF)
unnamed: R37.1, RN5.8, U8.12 (TOFF)
VS: C22.1, C24.1, C28.1, C30.1, C34.1, C36.1, U6.6 (VS), U7.6 (VS), U8.6 (VS); also elsewhere on the board
VSS: C26.1, C32.1, C38.1, RN3.2, RN3.4, RN4.2, RN4.4, RN5.2, RN5.4; also elsewhere on the board

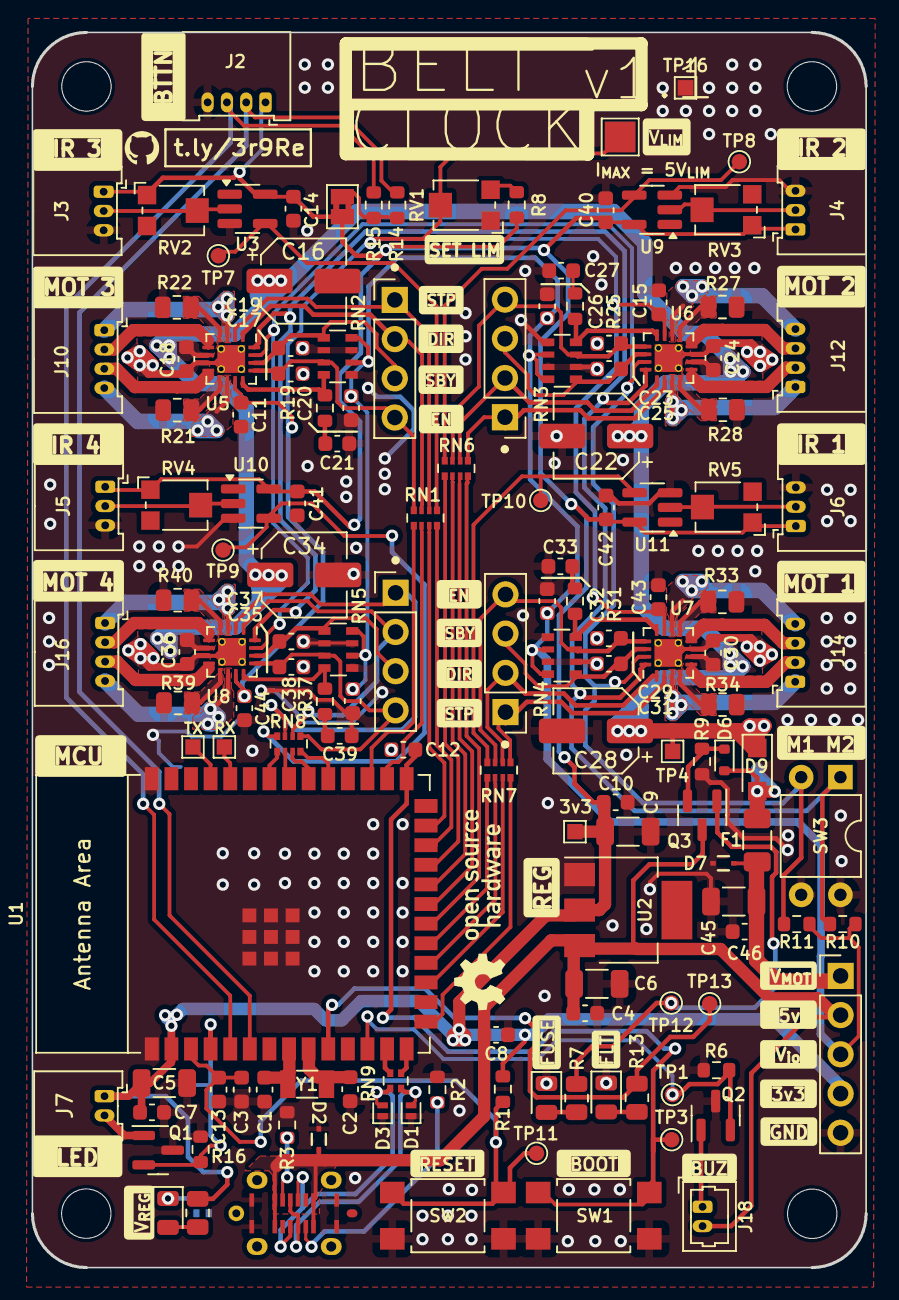
[picture p13: board motherboard_MK2.kicad_pcb from above]

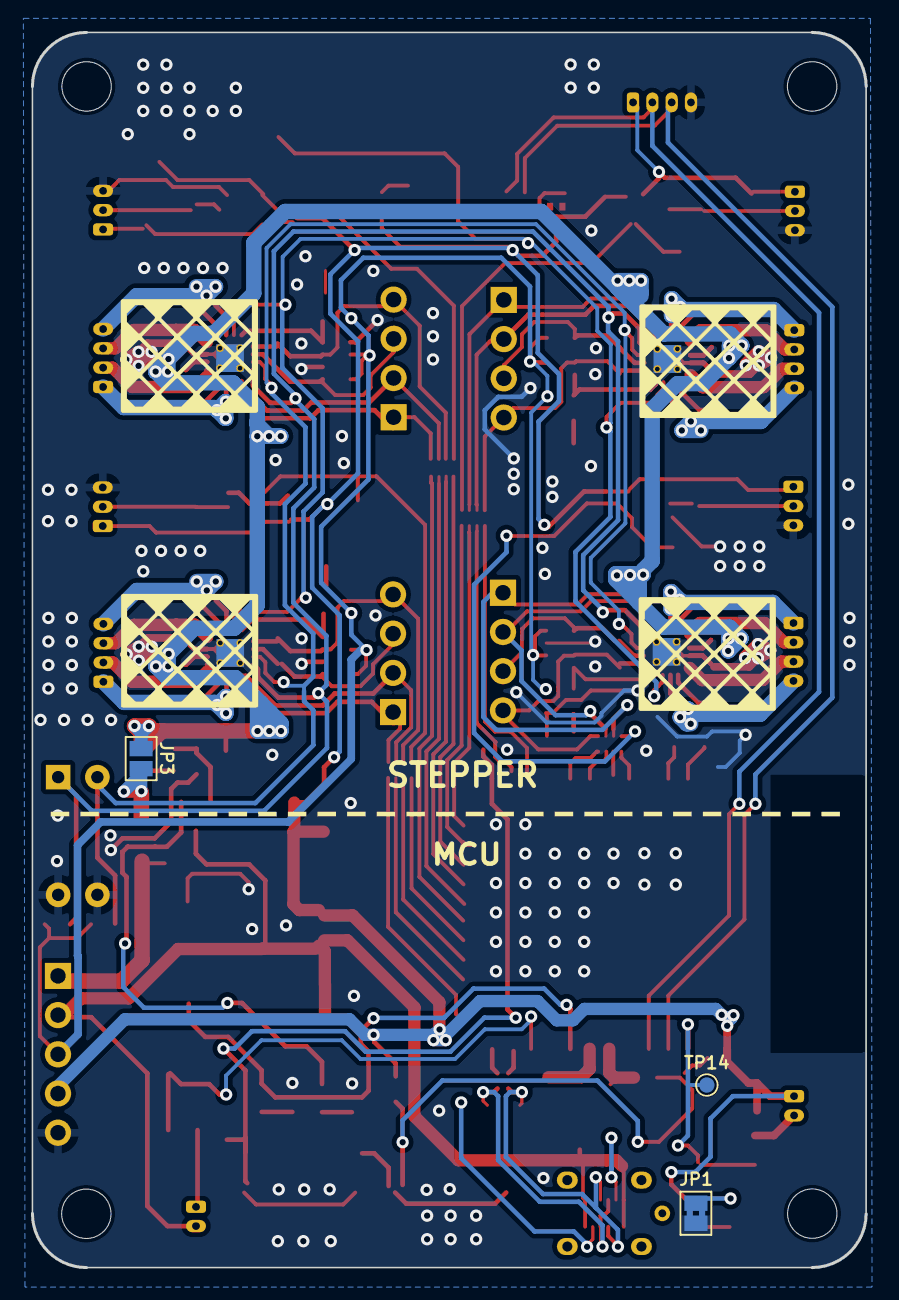
[picture p14: board motherboard_MK2.kicad_pcb from below]

Board: 2 copper layers, 54.0 x 80.0 mm, 153 parts (3 on the bottom side), 109 nets.
