test-account30/BeltClock/(commit log)

2025-01-04 Update and rename Board/motherboard.kicad_pcb to PCB/Board/motherboard.kicad_pcb
    [motherboard.kicad_pcb]
2025-01-04 Update and rename Board/motherboard.kicad_sch to PCB/Board/motherboard.kicad_sch
    [motherboard.kicad_sch]
